oesterle/geekyjacket/README.md

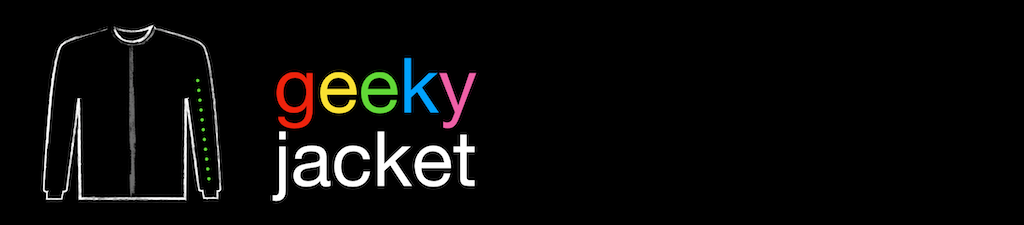
[picture p1: docs/banner_big.png]
geekyjacket banner


# geekyjacket
### Animate LEDs on your jacket with a Flutter app

Made at [DevCamp](https://devca.mp), February 1-3, 2019, by [Eric Oesterle](https://www.linkedin.com/in/ericoesterle/) & [Neil Heather](https://www.linkedin.com/in/neilheather/). Winner for [“Coolest Hack.”](https://devca.mp/unleashing-the-heroes-f48a241f72a6)

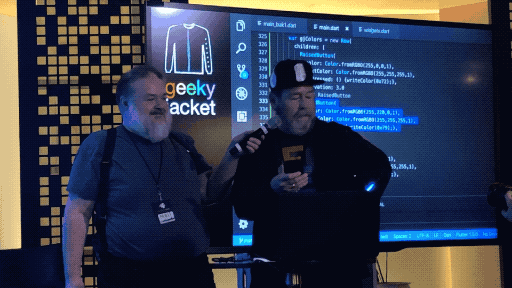
[picture p2: docs/gj_demo_vid.gif]
demo
  
[Watch a longer clip of the demo](https://twitter.com/erico/status/1092261259544674304)

A project connecting a mobile [Flutter](https://flutter.io) app to wearables via Bluetooth LE.

Uses the [flutter_blue](https://pub.dartlang.org/packages/flutter_blue) plugin to connect with an [Adafruit Feather M0 Bluefruit](https://www.adafruit.com/product/2995) microcontroller.

### Project structure
**[mobile_app](https://github.com/oesterle/geekyjacket/tree/master/mobile_app)** contains the Flutter project. We used VS Code to build. We've only tested the project on iOS so far. See **[docs](https://github.com/oesterle/geekyjacket/tree/master/docs)** for how to connect to and control geekyjacket from your phone.

**[firmware](https://github.com/oesterle/geekyjacket/tree/master/firmware)** contains Arduino code for the LEDs and the tiny tiny computer in your jacket. Be sure to install the board support package for your microcontroller. See the product guide for your MCU. For the [Adafruit Feather M0 Bluefruit](https://www.adafruit.com/product/2995), its this [product guide](https://learn.adafruit.com/adafruit-feather-m0-bluefruit-le/overview).

**[materials_and_construction](https://github.com/oesterle/geekyjacket/tree/master/materials_and_construction)** includes the list of materials, and will guide you through assembling the project and sewing it into the jacket sleeve. Don't sew, or in a hurry to make a low-fi prototype? We show you how to cheat with fabric tape.

### Running the app
See the annotated screenshots in the **[docs](https://github.com/oesterle/geekyjacket/tree/master/docs)** folder for
steps to get connected to **geekyjacket**. It's important to follow the steps to get the app to talk to the MCU. This process will be simplified in the future.
