oesterle/geekyjacket/docs/README.md

geekyjacket banner

# geekyjacket
### Getting Started

Launch the **geekyjacket** mobile app, then follow the steps below to connect to your microcontroller and change colors/animations on the jacket.

We plan to simplify this process in future iterations.

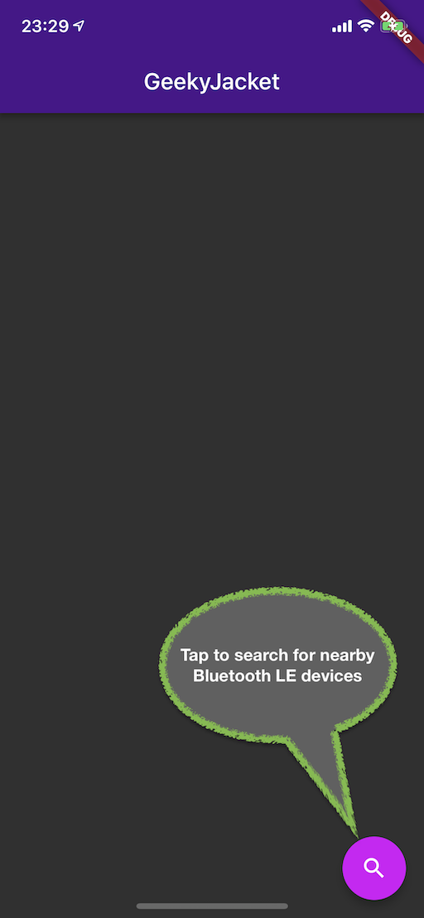
[picture p3: docs/gj_screen_1.png]
screen 1


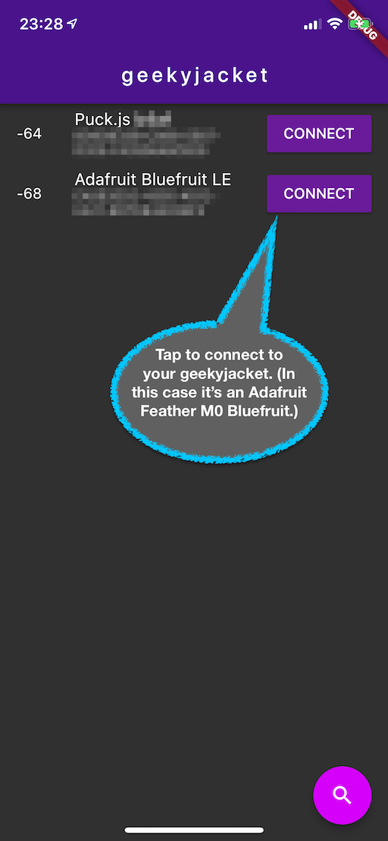
[picture p4: docs/gj_screen_2.png]
screen 2


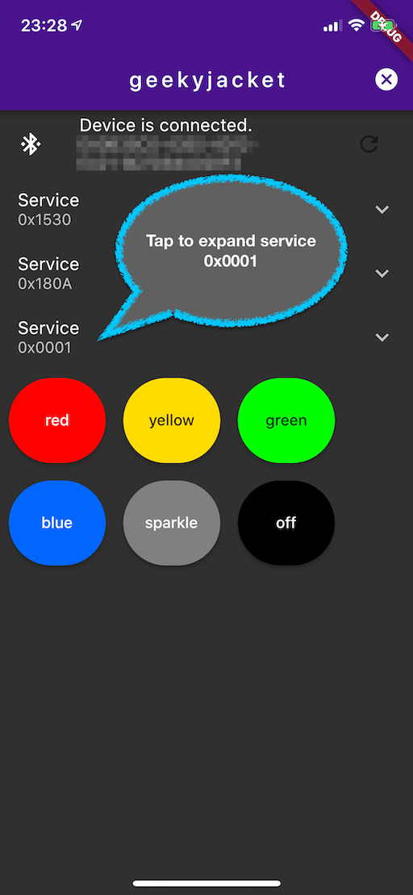
[picture p5: docs/gj_screen_3.png]
screen 3


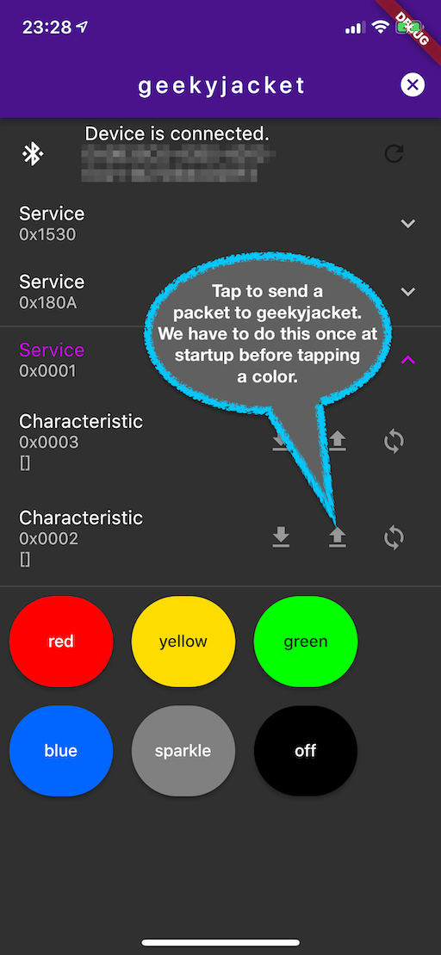
[picture p6: docs/gj_screen_4.png]
screen 4


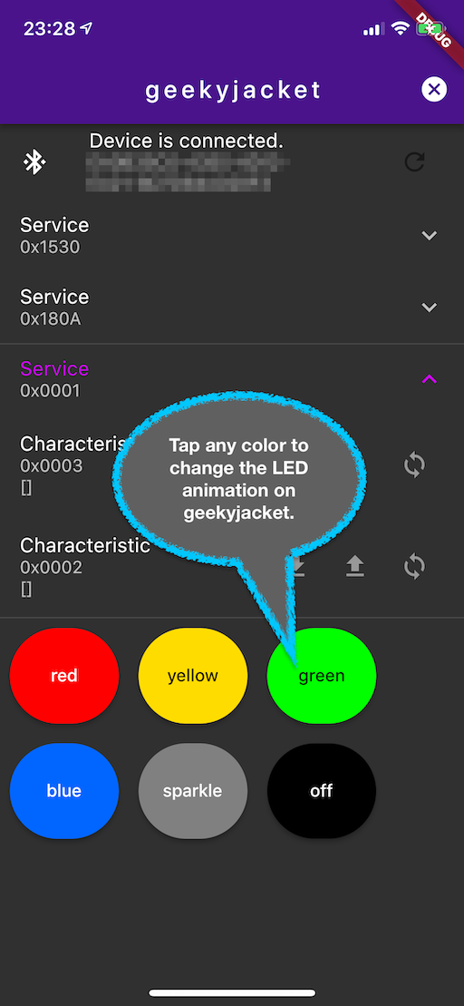
[picture p7: docs/gj_screen_5.png]
screen 5
