oesterle/geekyjacket/mobile_app/geekyjacket/README.md

geekyjacket banner

# geekyjacket

## Getting Started

Will add notes here; please see comments in Flutter source.
