oesterle/geekyjacket/(threads)

Thread 4 (2019-02-19):

Button label obscures taps

oesterle, 2019-02-19:
Caused by fix for issue #3.

Button label obscures taps to underlying raised button.

oesterle, 2019-02-19:
Closed with commit 5cf36be.

oesterle, 2019-02-19:
Closed with commit 5cf36be.

Closed 2019-02-19.

Thread 5 (2019-02-19):

Remove requirement to tap write characteristic button before tapping color button

oesterle, 2019-02-19:
Because we're hacking example code, we used tapping the **Write Characteristic** button in the **UART Service**'s *UART TX* characteristic (`0x0002`), in order to cache this characteristic for later writing color values.

oesterle, 2019-02-19:
Closed with commit 5cf36be.

Closed 2019-02-19.
