oesterle/geekyjacket/(commit log)

2019-02-12 Added docs on assembly
2019-02-19 Update main.dart
    Fixes #3 - Simplify and improve color buttons.
2019-02-19 Tappable button text; write characteristic caching
    Changes to address issues #4 and #5.
    * tappable button text
    * write characteristic caching
